pdisidore/DrainDefenders/(commit log)

2024-02-21 Changed Arduino sketch to src
2024-02-21 Added TimeLib needs to be included when running in arduino IDE
2024-05-07 Final Release Prototype
    Removed Unnecessary code, broke out code to increase readability, and finished project.
    [lte__sketch.ino]
2024-05-07 Final Change
    Pin mode error
    [lte__sketch.ino]
